tongclement/FBR-E-Throttle/README.md

## Resources

- [PID Controller in C](https://deepbluembedded.com/esp32-timers-timer-interrupt-tutorial-arduino-ide/)
- [ESP32 Arduino IDE Timer Interrupts Reference](https://deepbluembedded.com/esp32-timers-timer-interrupt-tutorial-arduino-ide/)
