tongclement/FBR-E-Throttle/Screenshot 2026-03-20 at 5.38.22 PM.png

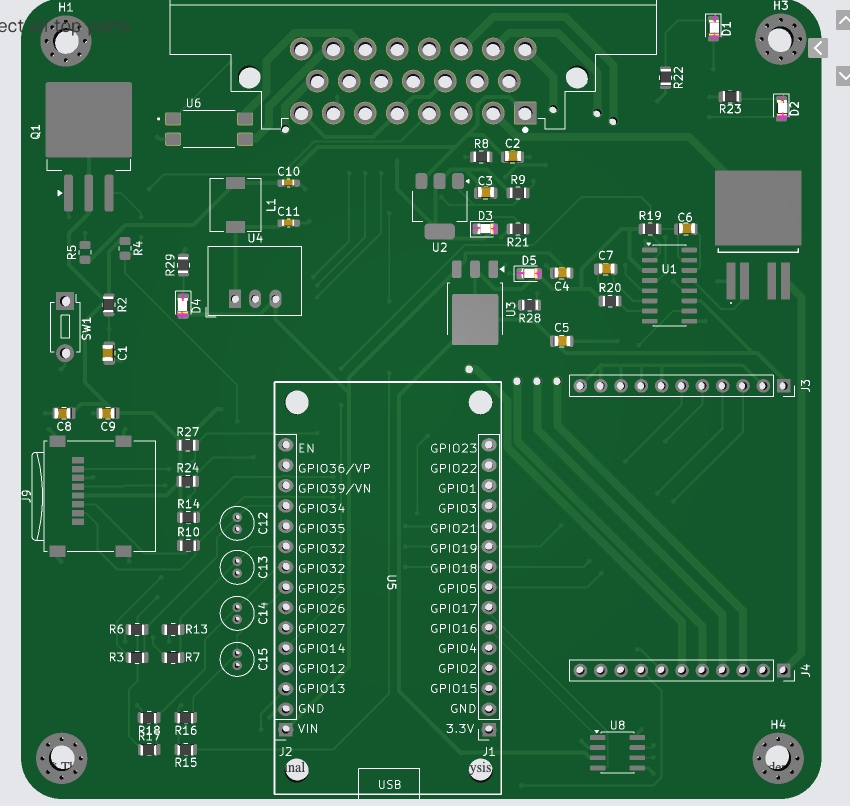
Screenshot 2026-03-20 at 5.38.22 PM.png
