tongclement/FBR-E-Throttle/E-throttle/Parts/TLP241A_TP1_F/TLP241A_TP1_F.step

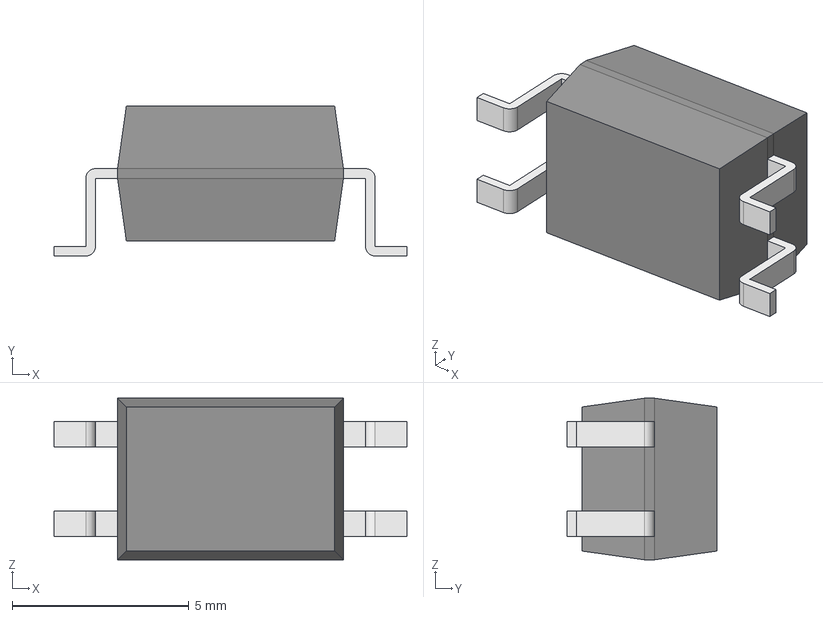
[picture p6: CAD file, 2026-03-08]
E-throttle/Parts/TLP241A_TP1_F/TLP241A_TP1_F.step
10.0 x 4.25 x 4.58 mm
Body001 (Mirror #1) x 2
XY-plane x 12
X-axis x 12
