tongclement/FBR-E-Throttle/E-throttle/E-throttle.kicad_pcb

## KiCad design E-throttle/E-throttle.kicad_pcb (2026-03-20)

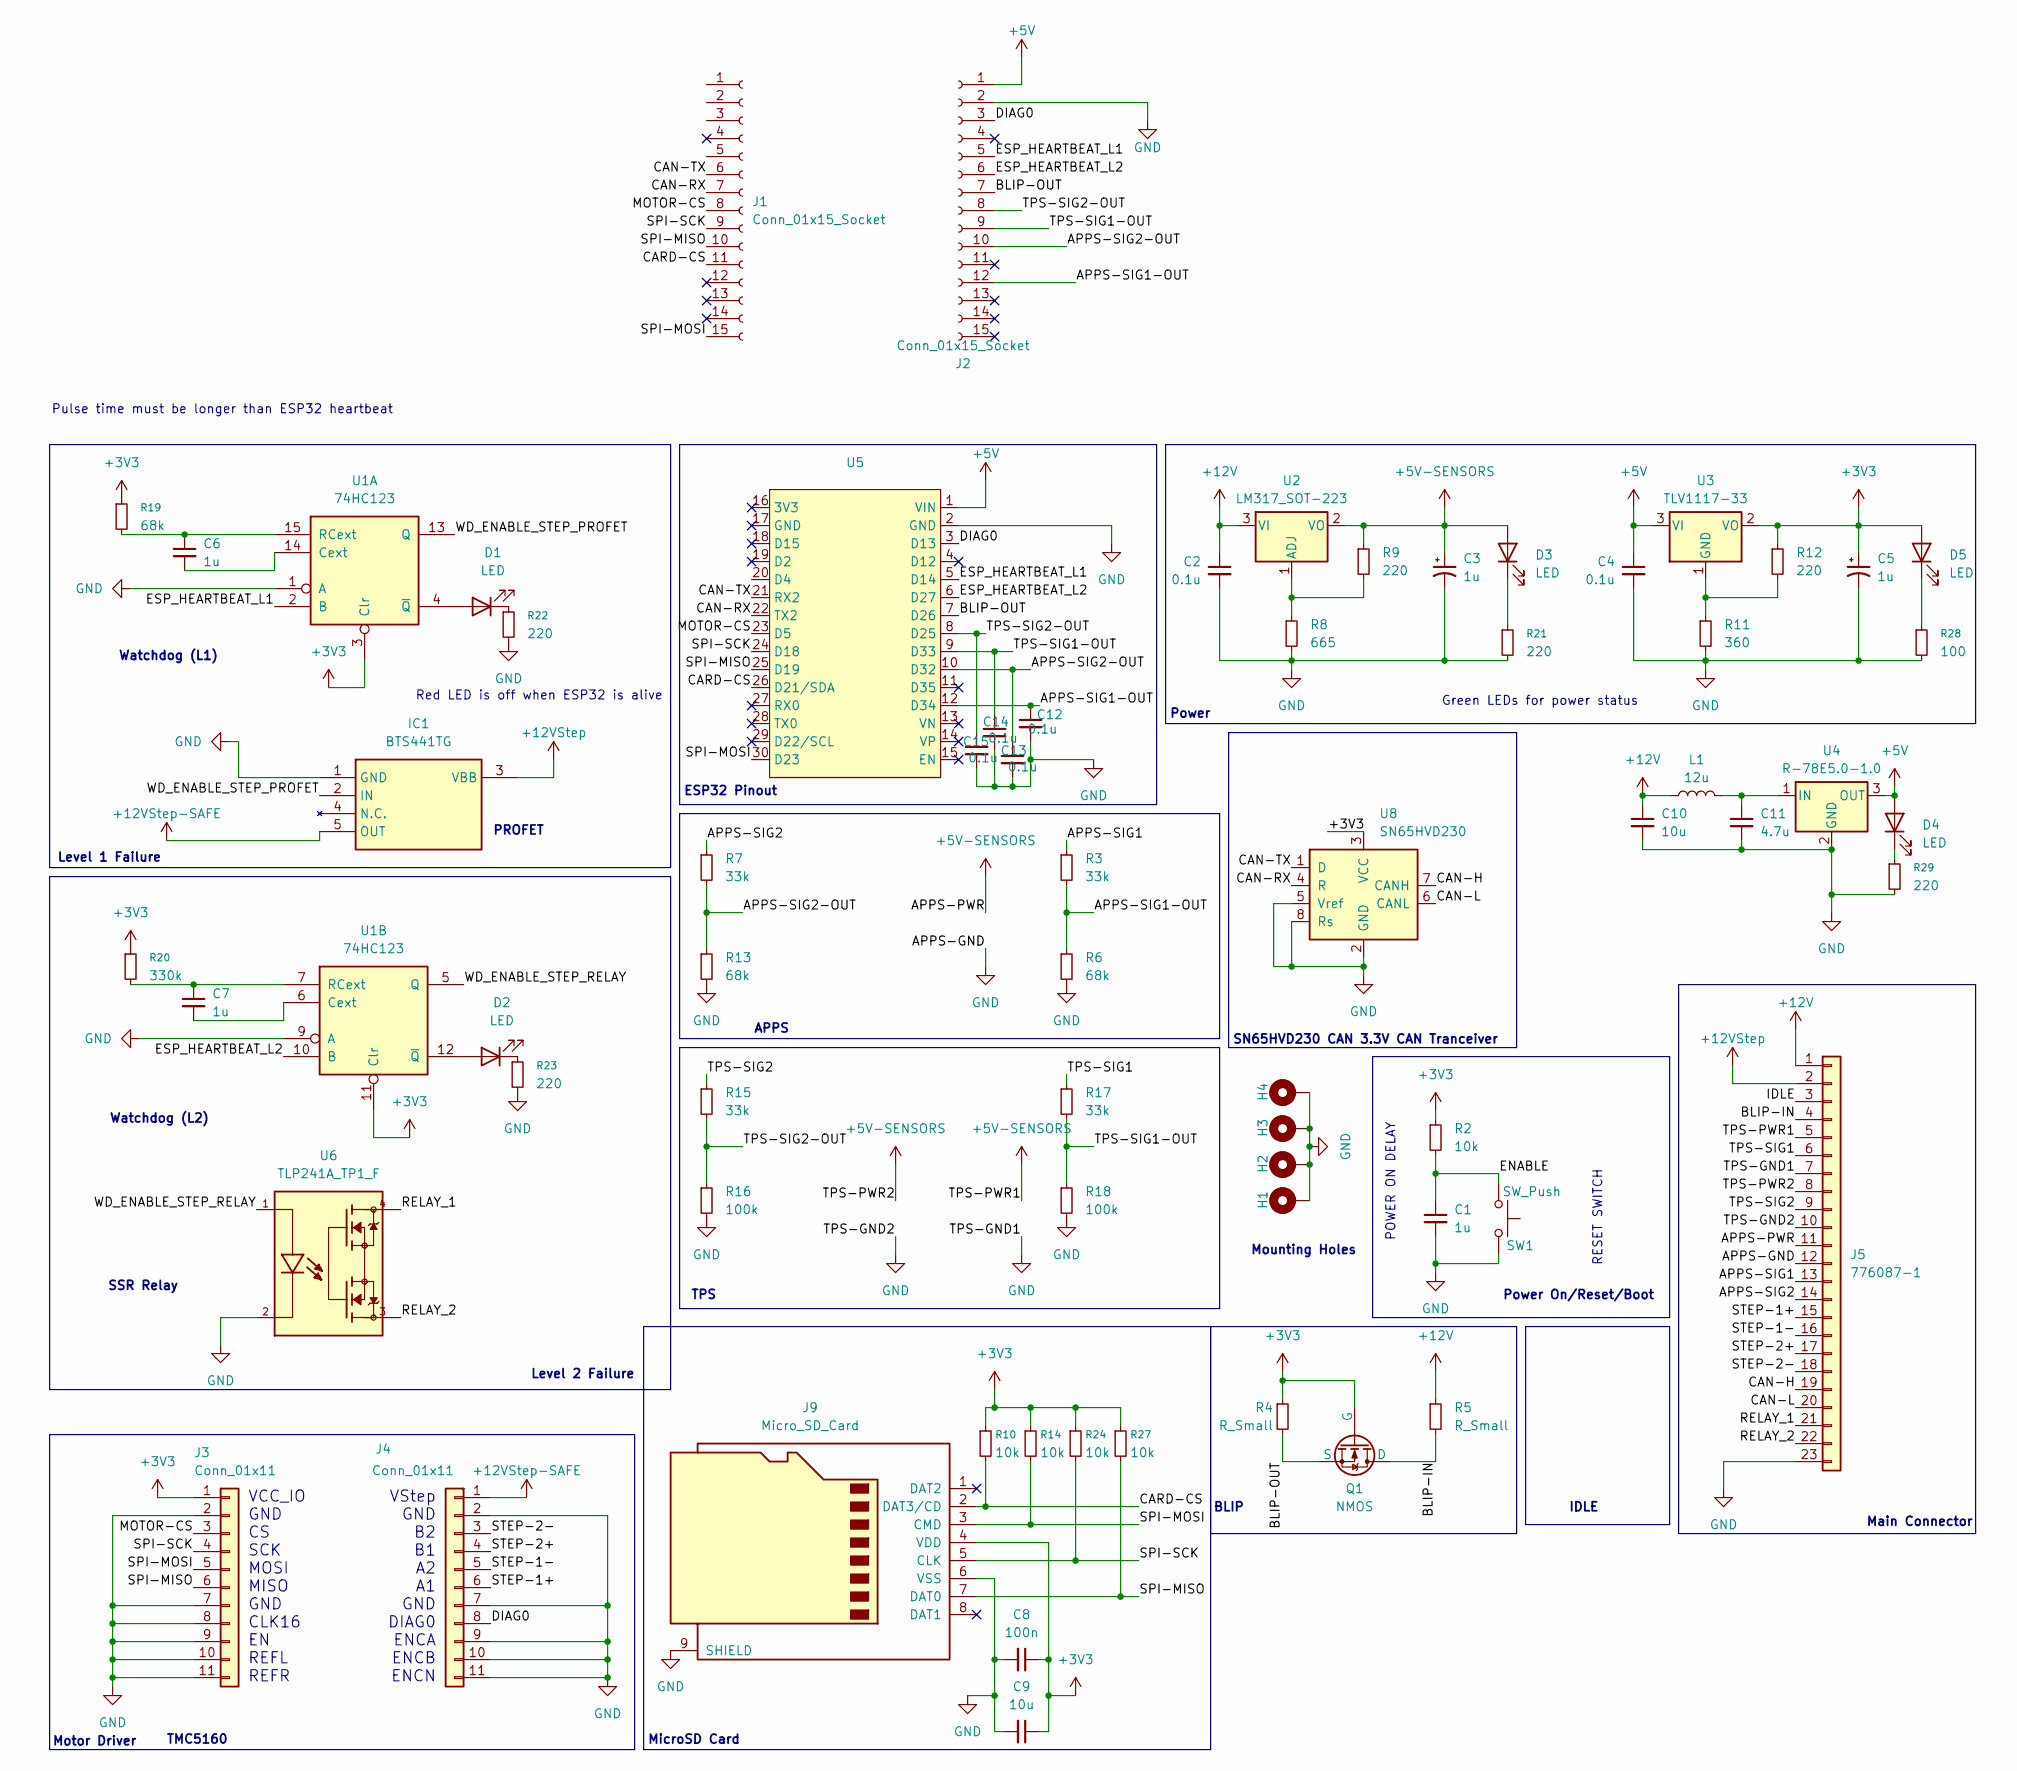
[picture p7: schematic E-throttle.kicad_sch]

Parts:
C1, C3, C5, C6, C7: 1u; C_0805_2012Metric
C2, C4: 0.1u; C_0805_2012Metric
C8: 100n; C_0805_2012Metric
C9: 10u; C_0805_2012Metric
C10: 10u; C_0603_1608Metric_Pad1.08x0.95mm_HandSolder
C11: 4.7u; C_0603_1608Metric_Pad1.08x0.95mm_HandSolder
C12, C13, C14, C15: 0.1u; C_Radial_D4.0mm_H7.0mm_P1.50mm
D1, D2: LED; LED_D5.0mm
D3, D4, D5: LED; LED_0805_2012Metric_Pad1.15x1.40mm_HandSolder
H1, H2, H3, H4: MountingHole_Pad; MountingHole_3.2mm_M3_Pad_Via
IC1: BTS441TG; Mouser Part Number 726-BTS441TG
J1, J2: Conn_01x15_Socket; PinSocket_1x15_P2.54mm_Vertical
J3, J4: Conn_01x11; PinSocket_1x11_P2.54mm_Vertical
J5: 776087-1; TE_776087-1
J9: Micro_SD_Card; microSD_HC_Wuerth_693072010801
L1: 12u; L_6.3x6.3_H3
Q1: NMOS; TO-263-3_TabPin2
R2, R10, R14, R24, R27: 10k; R_0805_2012Metric
R3, R7, R15, R17: 33k; R_0805_2012Metric
R4, R5: R_Small; R_0805_2012Metric
R6, R13, R19: 68k; R_0805_2012Metric
R8: 665; R_0805_2012Metric
R9, R12, R21, R22, R23, R29: 220; R_0805_2012Metric
R11: 360; R_0805_2012Metric
R16, R18: 100k; R_0805_2012Metric
R20: 330k; R_0805_2012Metric
R28: 100; R_0805_2012Metric
SW1: SW_Push; SW_PUSH_1P1T_6x3.5mm_H4.3_APEM_MJTP1243
U1: 74HC123; SOIC-16_3.9x9.9mm_P1.27mm
U2: LM317_SOT-223; SOT-223-3_TabPin2
U3: TLV1117-33; TO-252-3_TabPin2
U4: R-78E5.0-1.0; Converter_DCDC_RECOM_R-78E-0.5_THT
U5: ESP32_30pin
U6: TLP241A_TP1_F; SOIC254P1000X425-4N; PARTREV 7.0
U8: SN65HVD230; SOIC-8_3.9x4.9mm_P1.27mm

Connections:
+3V3: C5.1, C8.1, C9.1, D5.2 (A), J3.1, J9.4 (VDD), Q1.2 (G), R2.1, R4.1, R10.1, R12.1, R14.1, R19.1, R20.1, R24.1, R27.1, U1.3 (Clr), U1.11 (Clr), U3.2 (VO), U8.3 (VCC)
+5V: C4.1, D4.2 (A), J2.1, U3.3 (VI), U4.3 (OUT), U5.1 (VIN)
+5V-SENSORS: C3.1, D3.2 (A), J5.5, J5.8, J5.11, R9.1, U2.2 (VO)
+12V: C2.1, C10.1, J5.1, L1.1, R5.1, U2.3 (VI)
+12VStep: IC1.3 (VBB), J5.2
+12VStep-SAFE: IC1.5 (OUT), J4.1
/APPS-SIG1: J5.13, R3.1
/APPS-SIG1-OUT: C12.1, J2.12, R3.2, R6.1, U5.12 (D34)
/APPS-SIG2: J5.14, R7.1
/APPS-SIG2-OUT: C13.1, J2.10, R7.2, R13.1, U5.10 (D32)
/BLIP-IN: J5.4, Q1.1 (D), R5.2
/BLIP-OUT: J2.7, Q1.3 (S), R4.2, U5.7 (D26)
/CAN-H: J5.19, U8.7 (CANH)
/CAN-L: J5.20, U8.6 (CANL)
/CAN-RX: J1.7, U5.22 (TX2), U8.4 (R)
/CAN-TX: J1.6, U5.21 (RX2), U8.1 (D)
/CARD-CS: J1.11, J9.2 (DAT3/CD), R10.2, U5.26 (D21/SDA)
/DIAG0: J2.3, J4.8, U5.3 (D13)
/ENABLE: C1.1, R2.2, SW1.1
/ESP_HEARTBEAT_L1: J2.5, U1.2 (B), U5.5 (D14)
/ESP_HEARTBEAT_L2: J2.6, U1.10 (B), U5.6 (D27)
/IDLE: J5.3
/MOTOR-CS: J1.8, J3.3, U5.23 (D5)
/RELAY_1: J5.21, U6.4
/RELAY_2: J5.22, U6.3
/SPI-MISO: J1.10, J3.6, J9.7 (DAT0), R27.2, U5.25 (D19)
/SPI-MOSI: J1.15, J3.5, J9.3 (CMD), R14.2, U5.30 (D23)
/SPI-SCK: J1.9, J3.4, J9.5 (CLK), R24.2, U5.24 (D18)
/STEP-1+: J4.6, J5.15
/STEP-1-: J4.5, J5.16
/STEP-2+: J4.4, J5.17
/STEP-2-: J4.3, J5.18
/TPS-SIG1: J5.6, R17.1
/TPS-SIG1-OUT: C14.1, J2.9, R17.2, R18.1, U5.9 (D33)
/TPS-SIG2: J5.9, R15.1
/TPS-SIG2-OUT: C15.1, J2.8, R15.2, R16.1, U5.8 (D25)
/WD_ENABLE_STEP_PROFET: IC1.2 (IN), U1.13 (Q)
/WD_ENABLE_STEP_RELAY: U1.5 (Q), U6.1
GND: C1.2, C2.2, C3.2, C4.2, C5.2, C8.2, C9.2, C10.2, C11.2, C12.2, C13.2, C14.2, C15.2, H1.1, H2.1, H3.1, H4.1, IC1.1 (GND), J2.2, J3.2, J3.7, J3.8, J3.9, J3.10, J3.11, J4.2, J4.7, J4.9, J4.10, J4.11, J5.7, J5.10, J5.12, J5.23, J9.6 (VSS), J9.9 (SHIELD), R6.2, R8.2, R11.2, R13.2, R16.2, R18.2, R21.2, R22.2, R23.2, R28.2, R29.2, SW1.2, U1.1 (A), U1.9 (A), U4.2 (GND), U5.2 (GND), U6.2, U8.2 (GND), U8.5 (Vref), U8.8 (Rs)
unnamed: D1.2 (A), U1.4 (~Q)
unnamed: D1.1 (K), R22.1
unnamed: D2.2 (A), U1.12 (~Q)
unnamed: D2.1 (K), R23.1
unnamed: D3.1 (K), R21.1
unnamed: D4.1 (K), R29.1
unnamed: D5.1 (K), R28.1
unnamed: C6.2, U1.14 (Cext)
unnamed: C6.1, R19.2, U1.15 (RCext)
unnamed: C7.2, U1.6 (Cext)
unnamed: C7.1, R20.2, U1.7 (RCext)
unnamed: R8.1, R9.2, U2.1 (ADJ)
unnamed: R11.1, R12.2, U3.1 (GND)
unnamed: C11.1, L1.2, U4.1 (IN)

Notes on the sheet:
Motor Driver
PROFET
VStep GND B2 B1 A2 A1 GND DIAG0 ENCA ENCB ENCN
Level 2 Failure
Green LEDs for power status
Pulse time must be longer than ESP32 heartbeat
Red LED is off when ESP32 is alive
TPS
Mounting Holes
Power
Level 1 Failure
ESP32 Pinout
MicroSD Card
RESET SWITCH
POWER ON DELAY
BLIP
Main Connector
IDLE
Watchdog (L1)
TMC5160
VCC_IO GND CS SCK MOSI MISO GND CLK16 EN REFL REFR
SSR Relay
APPS
Power On/Reset/Boot
Watchdog (L2)
SN65HVD230 CAN 3.3V CAN Tranceiver

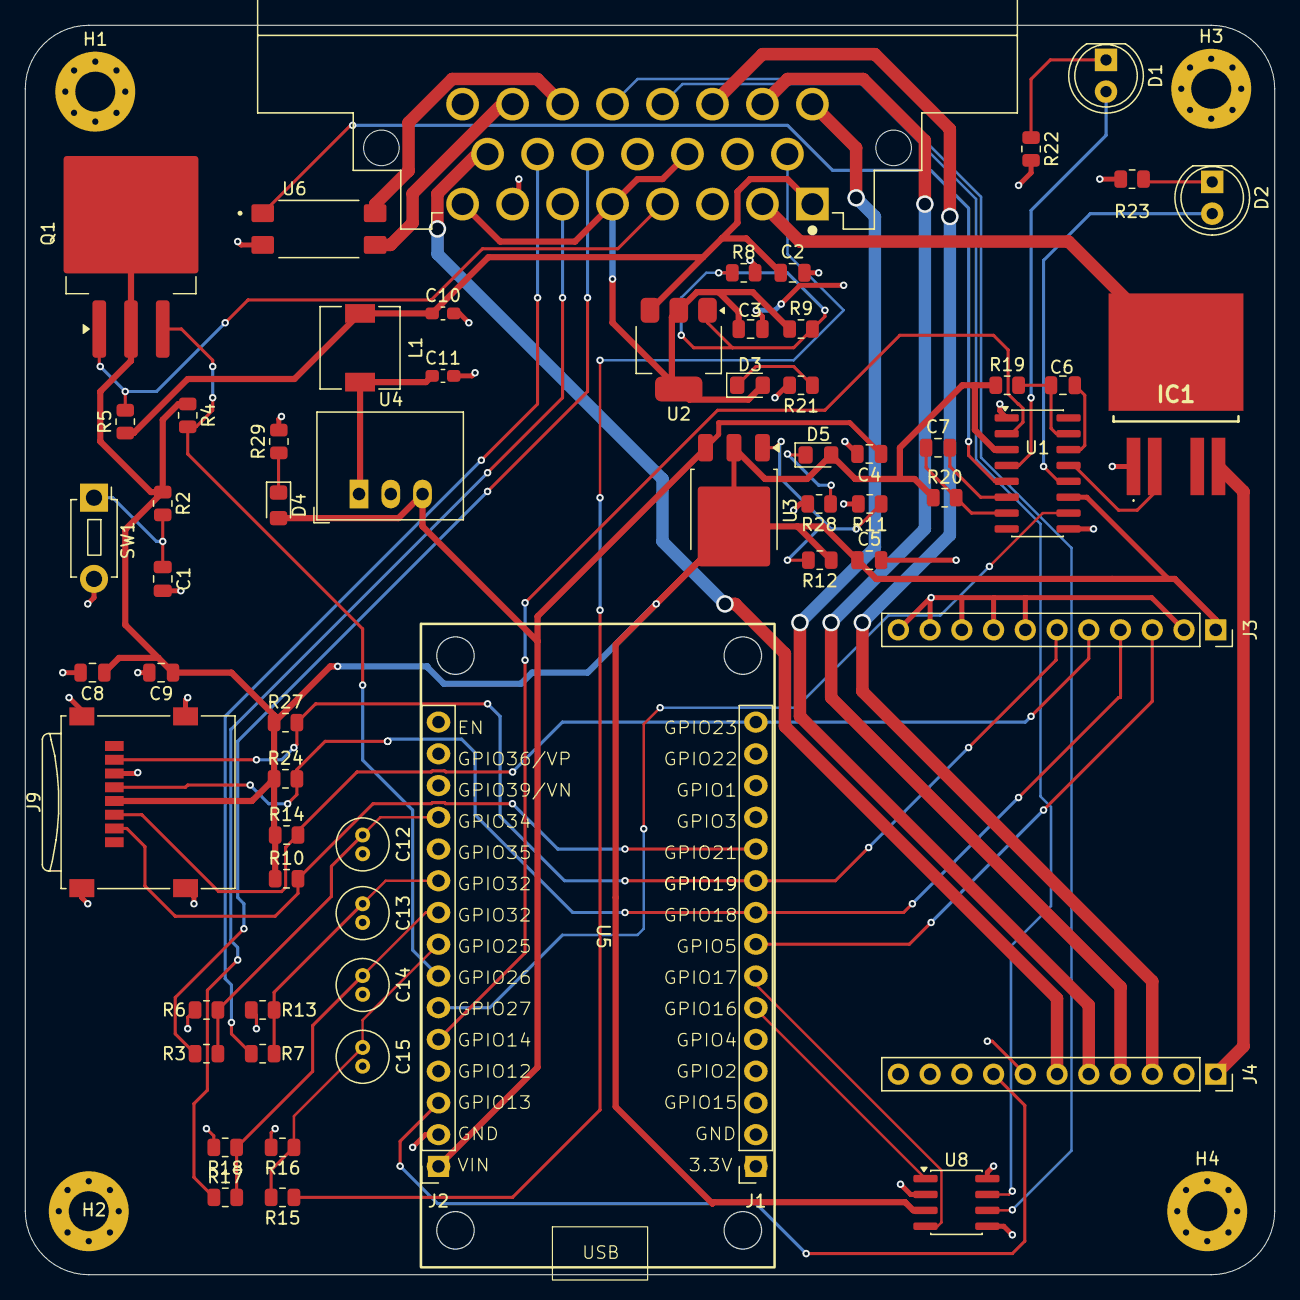
[picture p8: board E-throttle.kicad_pcb from above]

Board: 2 copper layers, 100.0 x 100.0 mm, 68 parts (1 on the bottom side), 52 nets.

Other parts of the board:
E-Throttle (2026): LOGO; FBR_Logo_.9in
