tongclement/FBR-E-Throttle/stepper_example.ino

/*
Connections:
  MOSI (Teensy : 11)  <=> SDI
  MISO (Teensy : 12)  <=> SDO
  SCK (Teensy : 13)   <=> SCK
  5                   <=> CSN
  8                   <=> DRV_ENN (optional, tie to GND if not used) - not used in testing last time
  GND                 <=> GND
  3.3V/5V             <=> VCC_IO (depending on the processor voltage)

The TMC5160 VS pin must also be powered.
Tie CLK16 to GND to use the TMC5160 internal clock.
Tie SPI_MODE to VCC_IO, SD_MODE to GND.
*/


#include <ArxTypeTraits.h>

#include <Bitfield.h>
#include <TMC5160.h>
#include <TMC5160_registers.h>

#include <Arduino.h>


const uint8_t SPI_CS = 2; // CS pin in SPI mode
//const uint8_t SPI_DRV_ENN = 8;  // DRV_ENN pin in SPI mode

TMC5160_SPI motor = TMC5160_SPI(SPI_CS); //Use default SPI peripheral and SPI settings.


void setup()
{
  // USB/debug serial coms
  Serial.begin(115200);

  //pinMode(SPI_DRV_ENN, OUTPUT); 
  //digitalWrite(SPI_DRV_ENN, LOW); // Active low

  // This sets the motor & driver parameters /!\ run the configWizard for your driver and motor for fine tuning !
  TMC5160::PowerStageParameters powerStageParams; // defaults.
  TMC5160::MotorParameters motorParams;
  motorParams.globalScaler = 98; // Adapt to your driver and motor (check TMC5160 datasheet - "Selecting sense resistors")
  motorParams.irun = 31;
  motorParams.ihold = 16;

  SPI.begin();
  motor.begin(powerStageParams, motorParams, TMC5160::NORMAL_MOTOR_DIRECTION);

  // ramp definition
  motor.setRampMode(TMC5160::POSITIONING_MODE);
  motor.setMaxSpeed(400);
  motor.setAcceleration(500);

  Serial.println("starting up");

  delay(1000); // Standstill for automatic tuning
}

void loop()
{
  uint32_t now = millis();
  static unsigned long t_dirchange, t_echo;
  static bool dir;

  // every n seconds or so...
  if ( now - t_dirchange > 3000 )
  {
    t_dirchange = now;

    // reverse direction
    dir = !dir;
    motor.setTargetPosition(dir ? 200 : 0);  // 1 full rotation = 200s/rev
  }

  // print out current position
  if( now - t_echo > 100 )
  {
    t_echo = now;

    // get the current target position
    float xactual = motor.getCurrentPosition();
    float vactual = motor.getCurrentSpeed();
    Serial.print("current position : ");
    Serial.print(xactual);
    Serial.print("\tcurrent speed : ");
    Serial.println(vactual);
  }
}
