tongclement/FBR-E-Throttle/(commit log)

2025-01-25 Original Files from Nod
    [E-throttle.kicad_pcb, E-throttle.kicad_sch]
2025-02-08 Lock file removed, ready for wiring.
    [E-throttle.kicad_pcb]
2025-02-09 Completed wiring 2.0
    [E-throttle.kicad_pcb, E-throttle.kicad_sch]
2025-02-19 Run DRC, generate Gerbers
    [E-throttle.kicad_pcb]
2026-01-27 Added stepper motor and APPS code
    Stepper motor movement mapped from APPS sensor reading
2026-01-29 Add potential PID controller code
2026-02-01 Added sensor readings for both APPS sensors
2026-02-08 Implemented RTOS Task, switching from Interupt Timer
    8/2/26
2026-02-27 Updated PCB for 2026 (v0.1)
    - Switch from ESP32 S3 Wroom1 Module to ESP dev board (Todo: Check Power Supply to ESP32 and other components)
    - Fixed incorrect TPS wiring (replaced variable resistors)
    - Did not reconnect JTAG debugger and programmer to ESP32 Dev Board
    - Did not reconnect CAN Transceiver
    [E-throttle.kicad_sch]
2026-02-27 Implemented Level 1 Failure Circuit
    - Added Hardware Watchdog (74HC123) that requires ESP32 to send "Heartbeat" alive signal every 20ms, or else the stepper motor power gets cut
    - Added PROFET / Automotive Smart High-Side Switch (BTS441TG) to cut power to the stepper motor, if the hardware watchdog doesn't receive a heartbeat from the ESP32 within the required timeframe (We set this hardware timeout to 50ms to comply with the FSUK rule CV1.6.4 that requires motor power to be cut if plausibility fails for more than 100ms)
    [E-throttle.kicad_sch]
2026-03-01 Updated schematic based on today's discussions
    Updated:
    - Second Watchdog with independent ESP heartbeat
    - Relay pins (21 and 22) from connector
    - BLIP and IDLE connected to ESP GPIO pins
    Not Added Yet:
    - Relay
    - Status LEDs
    - SD Card
    [E-throttle.kicad_sch]
2026-03-08 Added MicroSD Card to schematic
    [E-throttle.kicad_sch]
2026-03-08 Added status LEDs, reorganized schematic
    [E-throttle.kicad_sch]
2026-03-08 Added relay, added all footprints to schematic
    [E-throttle.kicad_pcb, E-throttle.kicad_sch, TLP241A_TP1_F.step]
2026-03-15 Initial PCB Layout edit
    - Added ESP32 Dev Board footprint
    - Expanded PCB layout edges
    - Added all components in new layout
    [E-throttle.kicad_pcb, E-throttle.kicad_sch]
2026-03-15 Adjusted layout, added ground plane
    [E-throttle.kicad_pcb, E-throttle.kicad_sch]
2026-03-16 Finalized Schematic (added power status LEDs, pull-up resistors for SD, separate 5V power) - not reviewed yet
    [E-throttle.kicad_sch]
2026-03-16 (Actually) finalized schematic - added status LED for 12V supply - need to review
    [E-throttle.kicad_sch]
2026-03-16 arranged components
    [E-throttle.kicad_pcb, E-throttle.kicad_sch]
2026-03-17 Added majority of routing to PCB layout
    [E-throttle.kicad_pcb, E-throttle.kicad_sch]
2026-03-18 added a few ground vias
    [E-throttle.kicad_pcb]
2026-03-18 Fix Stepper Driver Spacing
    [E-throttle.kicad_pcb]
2026-03-19 added vias, ran DRC
    [E-throttle.kicad_pcb, E-throttle.kicad_sch]
2026-03-19 Added THT filtering capacitors
    [E-throttle.kicad_pcb, E-throttle.kicad_sch]
2026-03-19 Added FBR Logo
    [E-throttle.kicad_pcb]
2026-03-19 Ran DRC - fixed all errors
    [E-throttle.kicad_pcb]
2026-03-19 Added Pin Sockets on top of ESP32 Dev Board footprint
    Set ESP32 Dev board to be a ghost footprint (not included in BOM, coordinates, etc)
    Added 2 1x15 female pin headers to the schematic, assigned them footprints, and aligned the precisely over the U5 pads using magnetic snapping to guarantee 25.4mm pitch
    [E-throttle.kicad_pcb, E-throttle.kicad_sch]
2026-03-19 Changed Stepper motor driver headers to female headers
    [E-throttle.kicad_pcb, E-throttle.kicad_sch]
2026-03-19 Deleted IDLE Control circuit
    Fully disconnected IDLE control pin from loom
    [E-throttle.kicad_pcb, E-throttle.kicad_sch]
2026-03-20 Fixed clearance issues to comply with DRC
    [E-throttle.kicad_pcb]
2026-03-20 changed 3V3 votlage regulator
    [E-throttle-B_Cu.gbl, E-throttle-B_Mask.gbs, E-throttle-B_Paste.gbp, E-throttle-B_Silkscreen.gbo, E-throttle-Edge_Cuts.gm1, E-throttle-F_Cu.gtl, E-throttle-F_Mask.gts, E-throttle-F_Paste.gtp]
2026-03-20 changed some resistor values
    [E-throttle.kicad_pcb, E-throttle.kicad_sch]
2026-03-20 pre-PCBA misc changes
